YanPei420/Team-14-Robot-Challenge/Auto_system/README.md

# Team 14 Robot Challenge - Auto System

This repository contains Team 14's robot firmware for the **Arduino Giga R1 WiFi** using PlatformIO and the Arduino framework.

## Assessment Version

The code to upload for the viva/test run is the active `src/main.cpp` entrypoint:

```cpp
#include "system.h"

void setup() { systemSetup(); }
void loop() { systemLoop(); }
```

`src/main.cpp` delegates to the full autonomous challenge system in `src/system.cpp` / `src/system.h`.

Assessment evidence is kept in:

- Software overview diagram: `docs/software_overview.md`
- Behaviour flowcharts: `docs/system_flowchart.md`
- Testing and calibration evidence: `docs/testing_calibration.md`
- Motor wiring notes: `lib/01 MotoronDrive/WIRING.md`
- Motor module notes: `lib/01 MotoronDrive/README.md`

## Repository Layout

```text
Auto_system/
|-- platformio.ini              PlatformIO configuration
|-- README.md                   Project overview
|-- AGENT.md                    Development notes for agents/developers
|-- include/
|   |-- WiFiHandlerConfig.h     WiFi, MQTT, and robot identity settings
|   `-- Encoder.h               Encoder helper definitions
|-- src/
|   |-- main.cpp                Active competition entrypoint
|   |-- main.cpp.bak            Previous entrypoint backup
|   |-- system.h
|   `-- system.cpp              Full autonomous competition system
|-- lib/
|   |-- 01 MotoronDrive/        Four-wheel Motoron drive wrapper
|   |-- 02 KillSwitch/          Emergency stop input
|   |-- 03 IR/                  9-channel line sensor array
|   |-- 04 LED/                 Status LED
|   |-- 05 ReviveButton/        Revive button input
|   |-- 06 RFID/                RFID reader wrapper
|   |-- 07 Lidar/               TF-Luna Lidar wrapper
|   |-- 08 Servo/               Servo helper/config
|   |-- 09 LineFollower/        IR + encoder line following
|   |-- 10 WallFollower/        Tunnel wall following with side Lidars
|   |-- 11 Planter/             Encoder-controlled planter cycle
|   |-- MiniMessenger-main/     WiFi/MQTT messaging
|   |-- Arduino_MFRC522v2-master/
|   `-- motoron-arduino-master/
|-- test/                       Module test sketches
|-- tool/                       Debugging and visualization tools
`-- docs/                       Diagrams, test evidence, datasheets, and notes
```

`.pio/` is generated by PlatformIO and should not be edited manually.

## Build Environment

- Board: Arduino Giga R1 WiFi
- Framework: Arduino
- Platform: ST STM32
- Default environment: `giga_m7`
- Secondary environment: `giga_m4`
- Monitor speed: `115200`

Common commands:

```bash
pio run
pio run -e giga_m7
pio run -e giga_m4
pio run -e giga_m7 --target upload
pio device monitor -b 115200
```

Managed dependencies in `platformio.ini`:

- `pololu/Motoron`
- `arduino-libraries/Servo`
- `arduino-libraries/ArduinoMqttClient`

## Competition System Overview

`src/system.cpp` contains the full autonomous challenge flow for the Giga M7 core. It initializes:

- Motoron drive and encoder speed control
- IR line sensors
- three Lidar sensors
- RFID reader
- kill switch
- revive button
- status LED
- MQTT messenger
- planter mechanism
- line follower and wall follower helpers

The component interaction diagram is in `docs/software_overview.md`.

The M4 build currently uses the stub branch in `system.cpp` and only delays in `systemLoop()`.

## Autonomous State Flow

The competition system uses this `RunState` enum:

```text
Idle
ExitLineToDoor
ExitRequest
ExitWaitDoor
ExitTraverseTunnel
GridDrive
SoilQuery
AlignSearch
FineAdjust
PlantOpen
PlantDrop
PlantVerify
ReturnToAirlock
EntryRequest
EntryWaitDoor
EntryTraverseTunnel
InsideBase
Stranded
ManualControl
PlanterTest
Finished
```

Typical autonomous path:

```text
Idle
  -> ExitLineToDoor
  -> ExitRequest
  -> ExitWaitDoor
  -> ExitTraverseTunnel
  -> GridDrive
  -> SoilQuery
  -> AlignSearch
  -> FineAdjust
  -> PlantOpen
  -> PlantVerify
  -> GridDrive
  -> ReturnToAirlock
  -> EntryRequest
  -> EntryWaitDoor
  -> EntryTraverseTunnel
  -> InsideBase
```

The system follows the line to the exit airlock, requests airlock B, wall-follows through the tunnel, drives the arena line, queries RFID soil data, plants up to 5 seeds, returns to airlock A, and reports mission completion.

Detailed Mermaid flowcharts for the runtime loop, safety gate, state transitions, inputs, and server outputs are in `docs/system_flowchart.md`.

## Safety Logic

Autonomous movement is allowed only when all safety conditions pass:

- Motor controller initialization succeeded.
- Kill switch is safe.
- `type=heartbeat enable=1` has been received.
- The heartbeat has not timed out.

If autonomous and local-control safety are both blocked, `systemLoop()` stops the robot, updates the LED, sends status, and returns.

Manual control and planter test mode are treated as local-control modes, but they still require the kill switch to be safe.

## MQTT Messages

Configuration is in `include/WiFiHandlerConfig.h`:

- `WIFI_SSID`
- `WIFI_PASSWORD`
- `BROKER_HOST`
- `BROKER_PORT`
- `GROUP_ID`
- `BOARD_ID`
- `SERVER_BOARD_ID`
- `WIFI_REGISTER_INTERVAL_MS`
- `WIFI_HEARTBEAT_TIMEOUT_MS`

Security note: WiFi credentials are currently stored in plain text. Remove or replace them before publishing the repository.

### Messages Sent By The Robot

```text
type=register team_id=14 board_id=Robot14
type=status team_id=14 board_id=Robot14 state=<state> seeds=<n> safety=<0|1>
type=openAirlockB team_id=14 board_id=Robot14
type=openAirlockA team_id=14 board_id=Robot14
type=isFertile team_id=14 board_id=Robot14 tag_id=<uid>
type=seedPlanted team_id=14 board_id=Robot14 tag_id=<uid> count=<n>
type=missionComplete team_id=14 board_id=Robot14 seeds=<n>
```

### Messages Received By The Robot

```text
type=heartbeat enable=1
type=heartbeat enable=0
type=start
type=stop
type=emergency
type=disable
type=openAirlockReply accepted=true airlock=A
type=openAirlockReply accepted=true airlock=B
type=isFertileReply tag_id=<uid> x=<n> y=<n> fertile=<true|false> planted=<true|false> blocked=<true|false>
type=rfid tag_id=<uid> x=<n> y=<n> fertile=<true|false> planted=<true|false> blocked=<true|false>
type=return
type=emergency_warning
type=stranded
type=revive
type=base_reached
```

RFID replies can update the internal 9 x 9 arena grid. Only the lower line-following rows are currently routeable.

## Serial Commands In `system.cpp`

Serial baud rate: `115200`

```text
S          start autonomous mission
R          request return to base
X          disable remote safety and stop
M          enter manual control
P          leave manual control and stop in Idle
W/B/A/D    manual forward/back/left/right
Q/E        manual rotate left/right
L          manual line follow
G          manual wall follow
O/C/T      run planter 180-degree cycle
0 or Space manual stop
+ / -      manual speed up/down
?          print help
```

In manual mode, `S` is interpreted as backward movement so the familiar `W/A/S/D` layout works.

## Hardware Modules

| Module | Location | Purpose |
| --- | --- | --- |
| MotoronDrive | `lib/01 MotoronDrive/` | Four-wheel Motoron drive, encoders, and speed control |
| KillSwitch | `lib/02 KillSwitch/` | Emergency stop protection |
| IRSensor | `lib/03 IR/` | 9-channel line sensor array |
| LED | `lib/04 LED/` | Normal, emergency, and button status |
| ReviveButton | `lib/05 ReviveButton/` | Revive from stranded state |
| RFIDHandler | `lib/06 RFID/` | Read soil tags |
| LidarSensor | `lib/07 Lidar/` | Door, wall, and obstacle sensing |
| ServoSweep | `lib/08 Servo/` | Servo helper/config |
| LineFollower | `lib/09 LineFollower/` | IR line following with encoder support |
| WallFollower | `lib/10 WallFollower/` | Tunnel centering using left/right Lidar |
| Planter | `lib/11 Planter/` | Encoder-controlled planting cycle |
| MiniMessenger | `lib/MiniMessenger-main/` | MQTT communication |

## Key Parameters

Most autonomous behavior constants are near the top of `src/system.cpp`:

```text
LINE_SPEED
GRID_SPEED
RETURN_SPEED
TUNNEL_SPEED
FINE_ADJUST_SPEED
AVOID_TURN_SPEED
DOOR_DETECTED_DISTANCE_CM
DOOR_OPEN_DISTANCE_CM
OBSTACLE_DISTANCE_CM
TUNNEL_TRAVERSE_MS
ARENA_TIME_LIMIT_MS
MAX_SEEDS
GRID_WIDTH / GRID_HEIGHT
```

Motor direction, Motoron addresses, encoder pins, and speed-control tuning are in:

```text
lib/01 MotoronDrive/include/MotorConfig.h
```

IR, Lidar, RFID, button, LED, servo, wall-following, line-following, and planter settings live in their module `include/` config headers.

## Testing Notes

Before powered movement tests:

1. Lift the robot or remove the wheels.
2. Confirm that the kill switch stops motion.
3. Run `pio run`.
4. Upload only the intended entrypoint.
5. Open the serial monitor at `115200`.
6. For autonomous mode, confirm the server is sending `type=heartbeat enable=1`.
7. Start autonomous mode with serial `S` or MQTT `type=start`.

Module tests are available in `test/`, including:

```text
test/Motor_run.cpp
test/line_follow.cpp
test/wall_follow.cpp
test/Lidar_test.cpp
test/RFID_test.cpp
test/servo_test.cpp
test/encoder_test.cpp
test/wifi.cpp
```

`test/line_follow.cpp` supports real-time serial PD tuning while the follower
runs:

```text
kp=0.08
kd=0.004
pd 0.07 0.004
show
help
```

Commands are applied when the serial monitor sends a newline. A leading `!`
is also accepted, for example `!kp=0.08`.

Debugging tools are available in `tool/`, including the navigation visualizer.

The viva evidence log, calibration values, current limitations, and final-day checklist are in `docs/testing_calibration.md`.
