YanPei420/Team-14-Robot-Challenge/Pinout.md

| Pin | IR Sensor | Description |
|:----|:---|:---|
| D45 | IR 1 | Chip select |
| D46 | IR 2 | Chip select |
| D47 | IR 3 | Chip select |
| D48 | IR 4 | Chip select |
| D49 | IR 5 | Chip select |
| D50 | IR 6 | Chip select |
| D51 | IR 7 | Chip select |
| D52 | IR 8 | Chip select |
| D53 | IR 9 | Chip select |

| Pin | RFID | Description |
|:----|:---|:---|
| D13 | SCL | Chip select |
| D14 | SDA | Chip select |

| Pin | LiDAR | Left to Right 1-6 (facing up) |
|:----|:---|:---|
| 5V | VCC | White |
| TX1 | Left | Blue |
| RX1 | Left | green |
| TX2 | Right | Blue |
| RX2 | Right | green |
| TX3 | Front | Blue |
| RX3 | Front | green |
| GND | GND  | Yellow |
| Unused | / | Black |
| Unused | / | Red |

| Pin | Servo | Description |
|:----|:---|:---|
| D2 | Data | Orange |
| 5V | VCC | Red |
| GND | GNC | Black |

| Pin | Revival Button | Description |
|:----|:---|:---|
| D17 | VCC | Red |
| GND | GND | Black |

| Pin | LED | Description |
|:----|:---|:---|
| D32 | Red | Red |
| D34 | Green | Green |
| GND | GND | Black |

| Pin | Motor | Description |
|:----|:---|:---|
| D2 | Encodder Pin 1 | |
| D3 | Encodder Pin 2 | |
| D4 | Encodder Pin 1 | |
| D5 | Encodder Pin 2 | |
| D6 | Encodder Pin 1 | |
| D7 | Encodder Pin 2 | |
| D8 | Encodder Pin 1 | |
| D9 | Encodder Pin 2 | |
| GND | Encoder GND | |
| 3.3V | Encoder Power | |

| Pin | Micromotor | Description |
|:----|:---|:---|
| GND | GND | Blue |
| 3.3V | VCC | Black |
| D | C1 (encoder pin) | Green |
| D | C2 (encoder pin) | Yellow |
| Channel 3A (Motor Shield) | M1 | White |
| Channel 3B (Motor Shield) | M2 | Red |

| Pin | Solar Panel | Description |
|:----|:---|:---|
| GND | GND | Black |
| A2 | VCC | Red |
