YanPei420/Team-14-Robot-Challenge/Auto_system/docs/website.md

https://ros-mobile-robots.com/DG01D-E-motor-with-encoder/
