YanPei420/Team-14-Robot-Challenge/Components/Remove Top Schematic.drawio.png

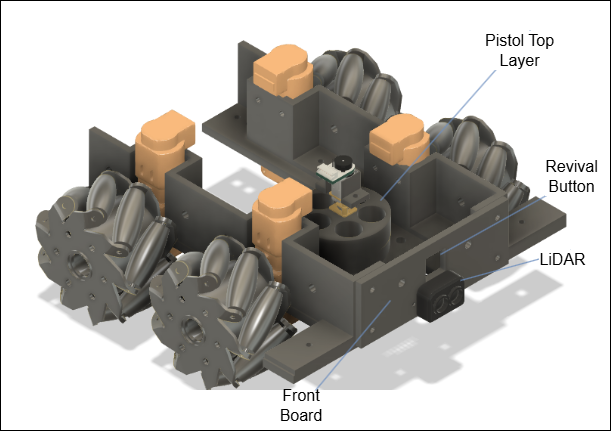
Components/Remove Top Schematic.drawio.png
