YanPei420/Team-14-Robot-Challenge/Components/Schematic Diagram.drawio.png

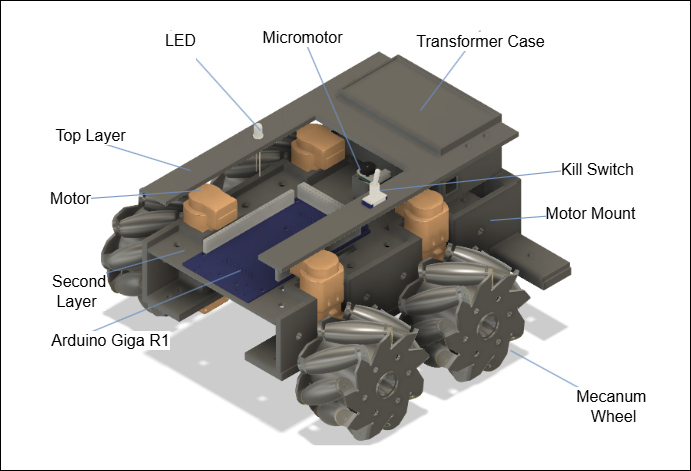
Components/Schematic Diagram.drawio.png
