YanPei420/Team-14-Robot-Challenge/Flowcharts/Emergency_alarm.drawio.png

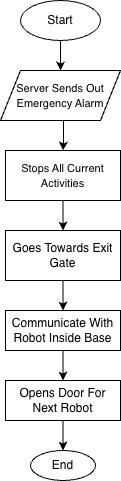
Flowcharts/Emergency_alarm.drawio.png
