YanPei420/Team-14-Robot-Challenge/Flowcharts/Kill_switch.drawio.png

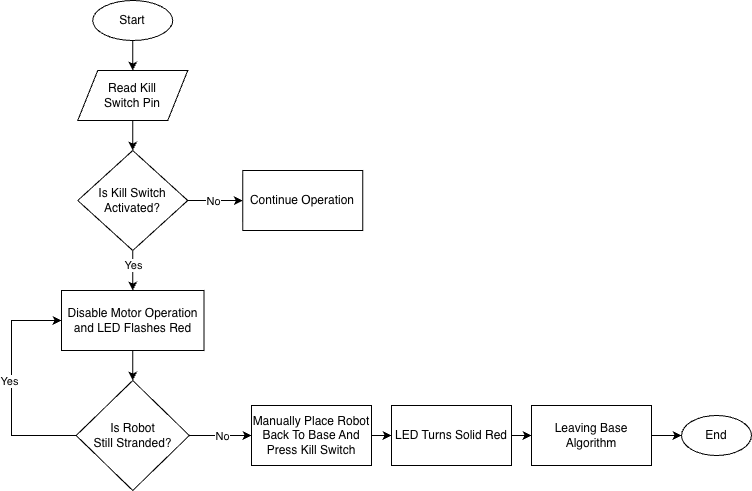
Flowcharts/Kill_switch.drawio.png
