YanPei420/Team-14-Robot-Challenge/Flowcharts/Leaving_base.drawio.png

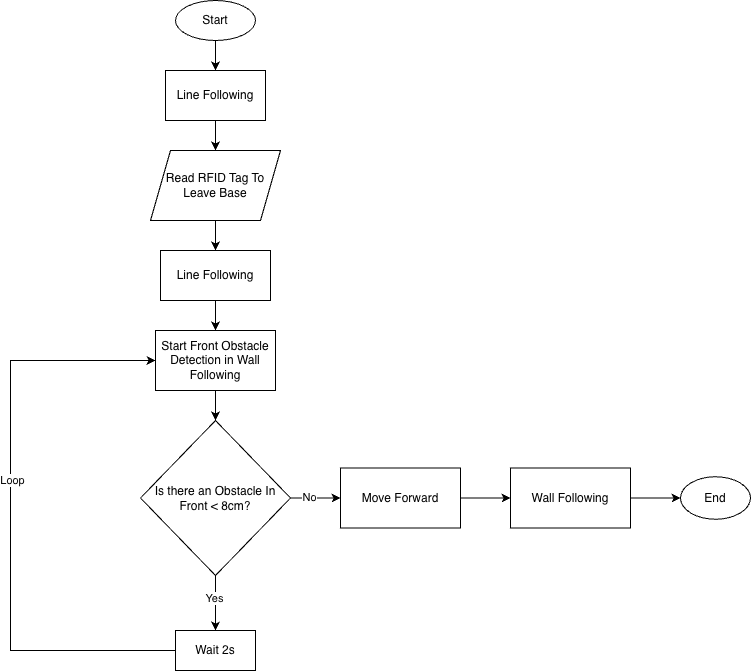
Flowcharts/Leaving_base.drawio.png
