YanPei420/Team-14-Robot-Challenge/Flowcharts/line_following.drawio.png

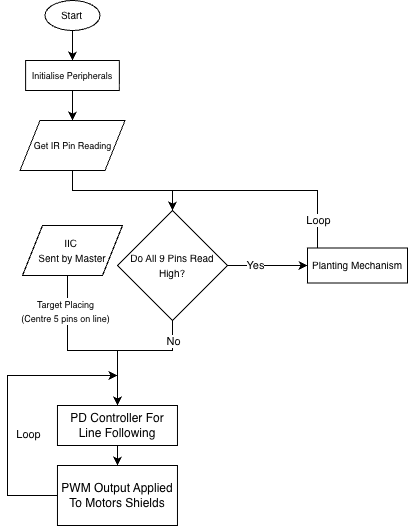
Flowcharts/line_following.drawio.png
