YanPei420/Team-14-Robot-Challenge/Flowcharts/planting.drawio.png

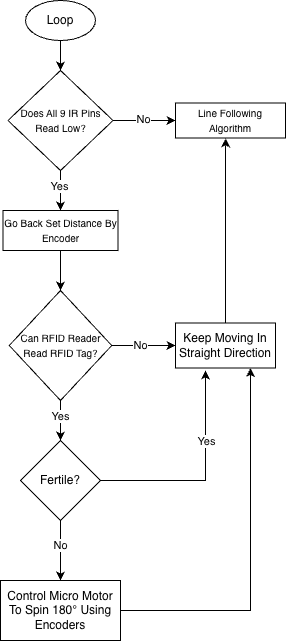
Flowcharts/planting.drawio.png
