YanPei420/Team-14-Robot-Challenge/Flowcharts/Solar Panel Flowchart.drawio.png

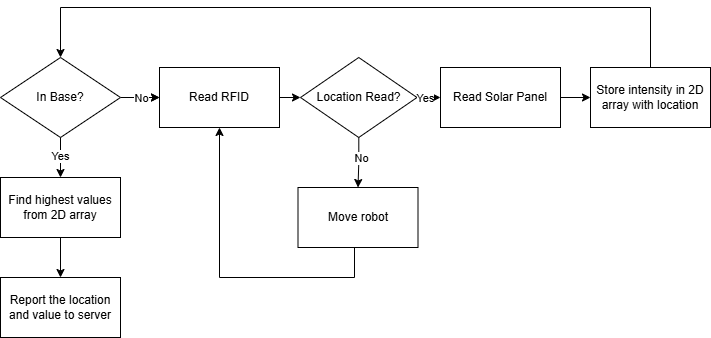
Flowcharts/Solar Panel Flowchart.drawio.png
