YanPei420/Team-14-Robot-Challenge/Flowcharts/wall_following.drawio.png

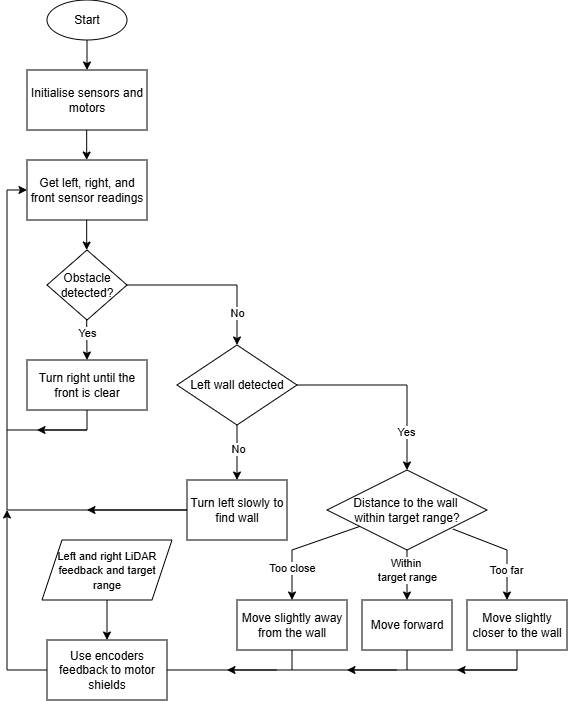
Flowcharts/wall_following.drawio.png
