YanPei420/Team-14-Robot-Challenge/Bill_of_Materials.md

Here is the link to our BoM:
[BoM](https://liveuclac-my.sharepoint.com/:x:/r/personal/zcabypz_ucl_ac_uk/Documents/Bom%20for%20interim%20report-%20team%2014.xlsx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)
