YanPei420/Team-14-Robot-Challenge/Components/Base Layer.drawio.png

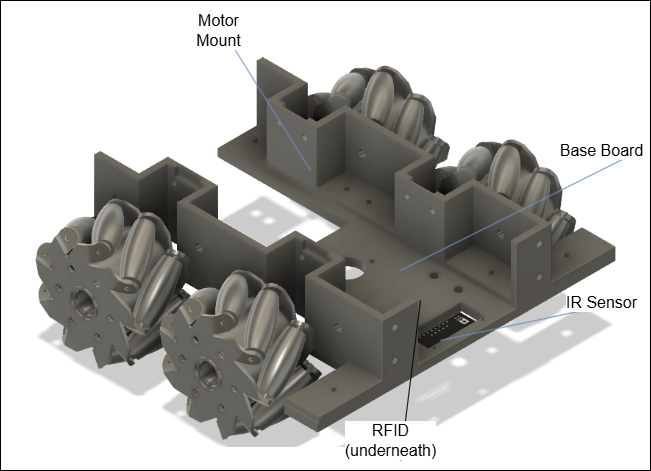
Components/Base Layer.drawio.png
