YanPei420/Team-14-Robot-Challenge/CAD/futaba_horn_type_A.STL

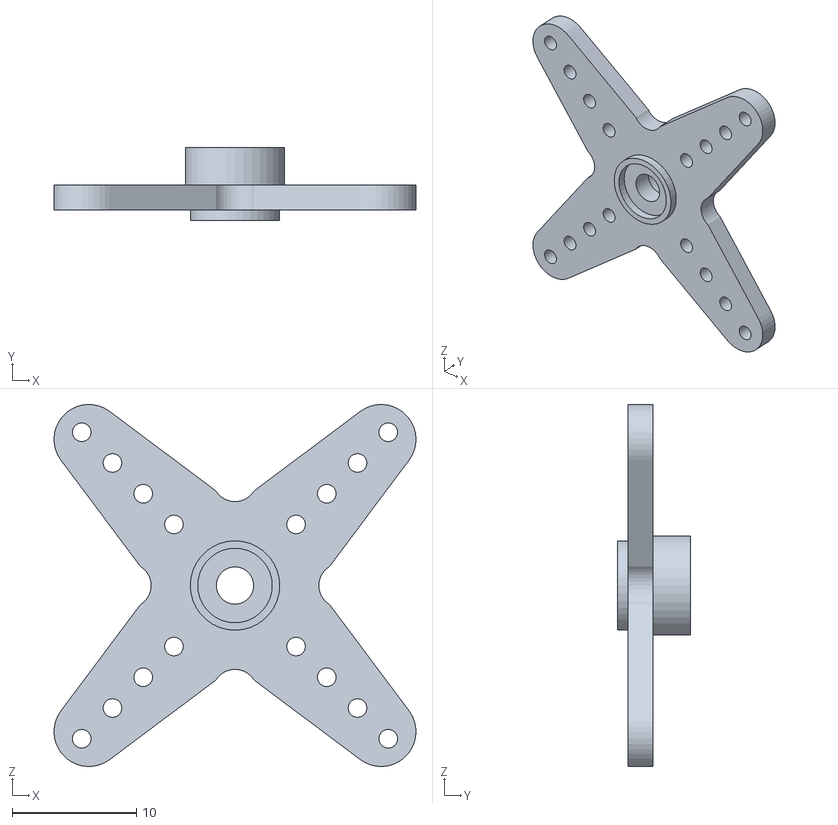
[picture p11: CAD file, 2026-04-28, last stored version]
CAD/futaba_horn_type_A.STL
29.1 x 5.85 x 29.1
