YanPei420/Team-14-Robot-Challenge/docs/Pololu_continuous_motor.pdf

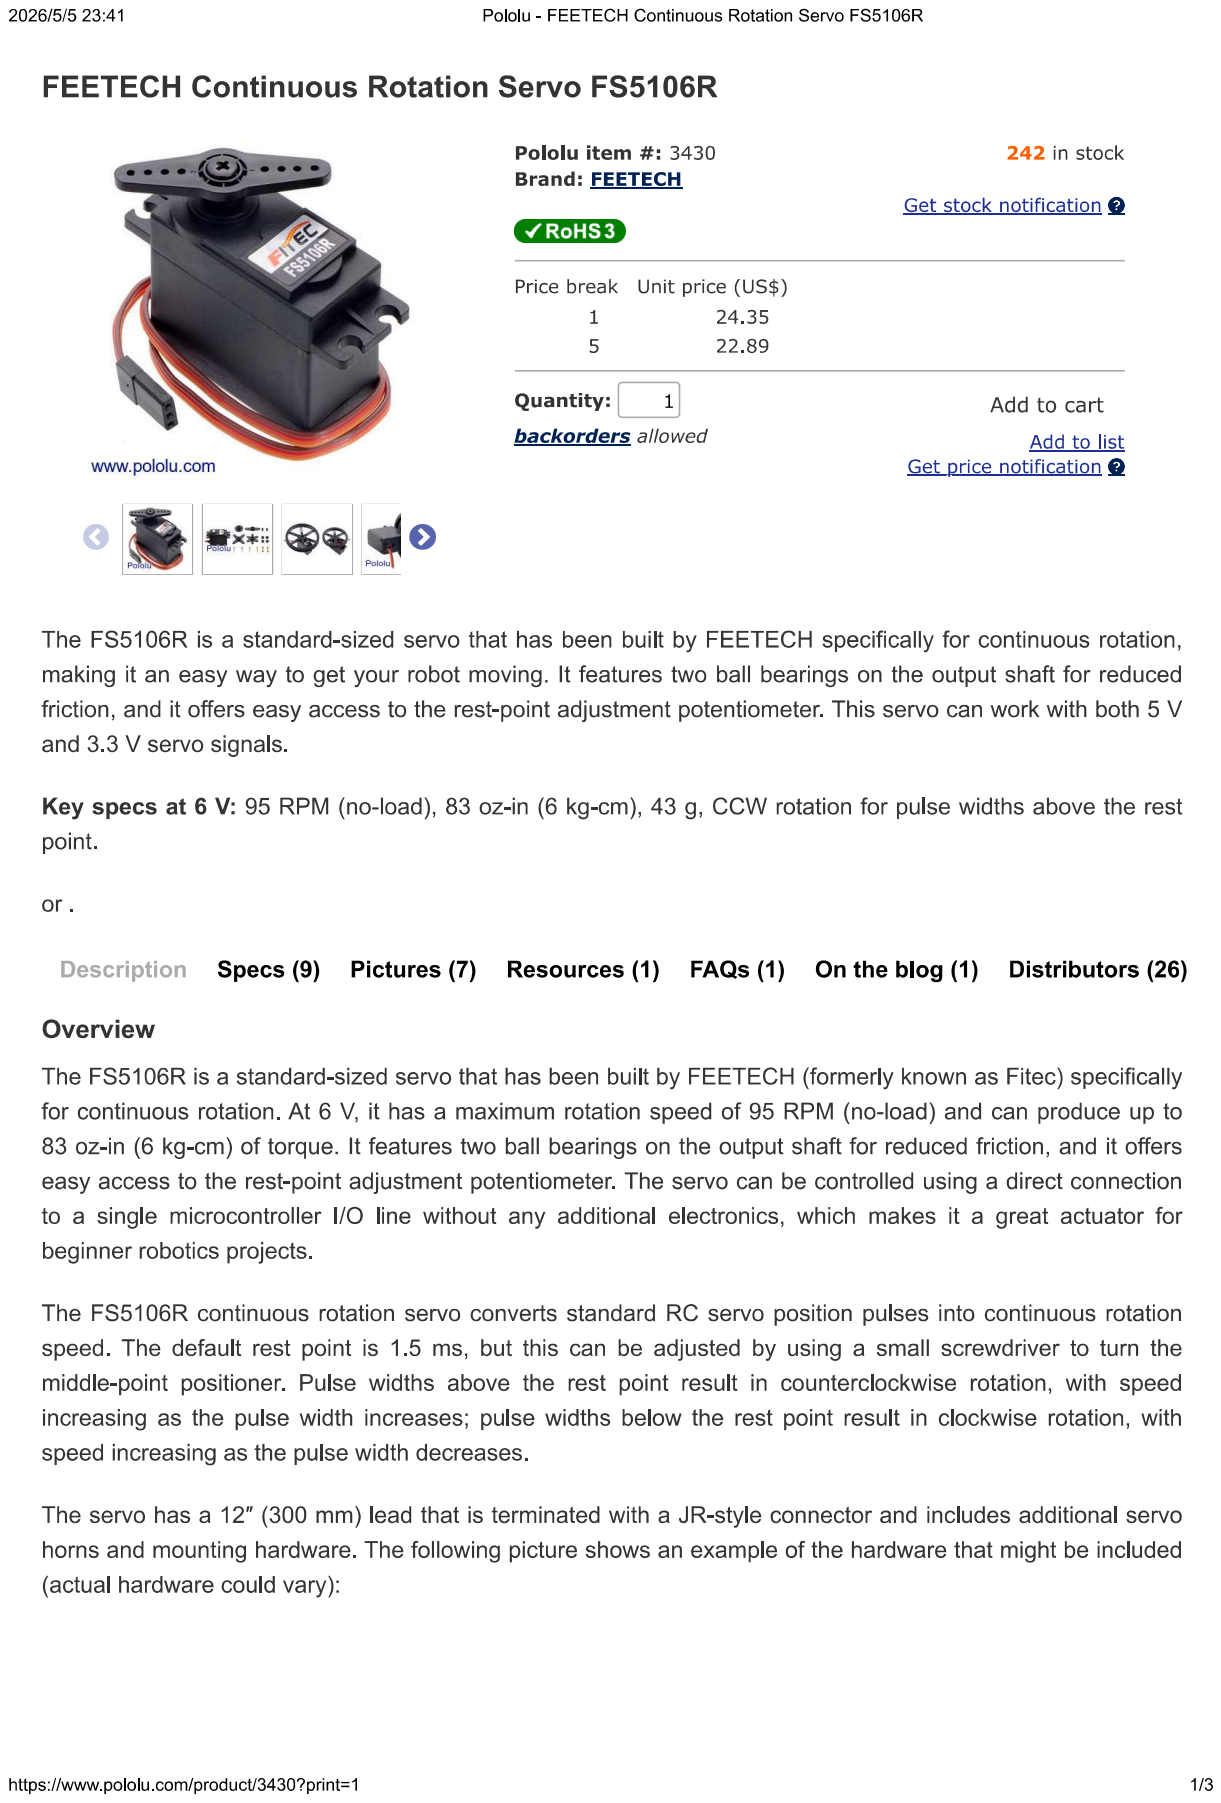
[picture p12: page 1]

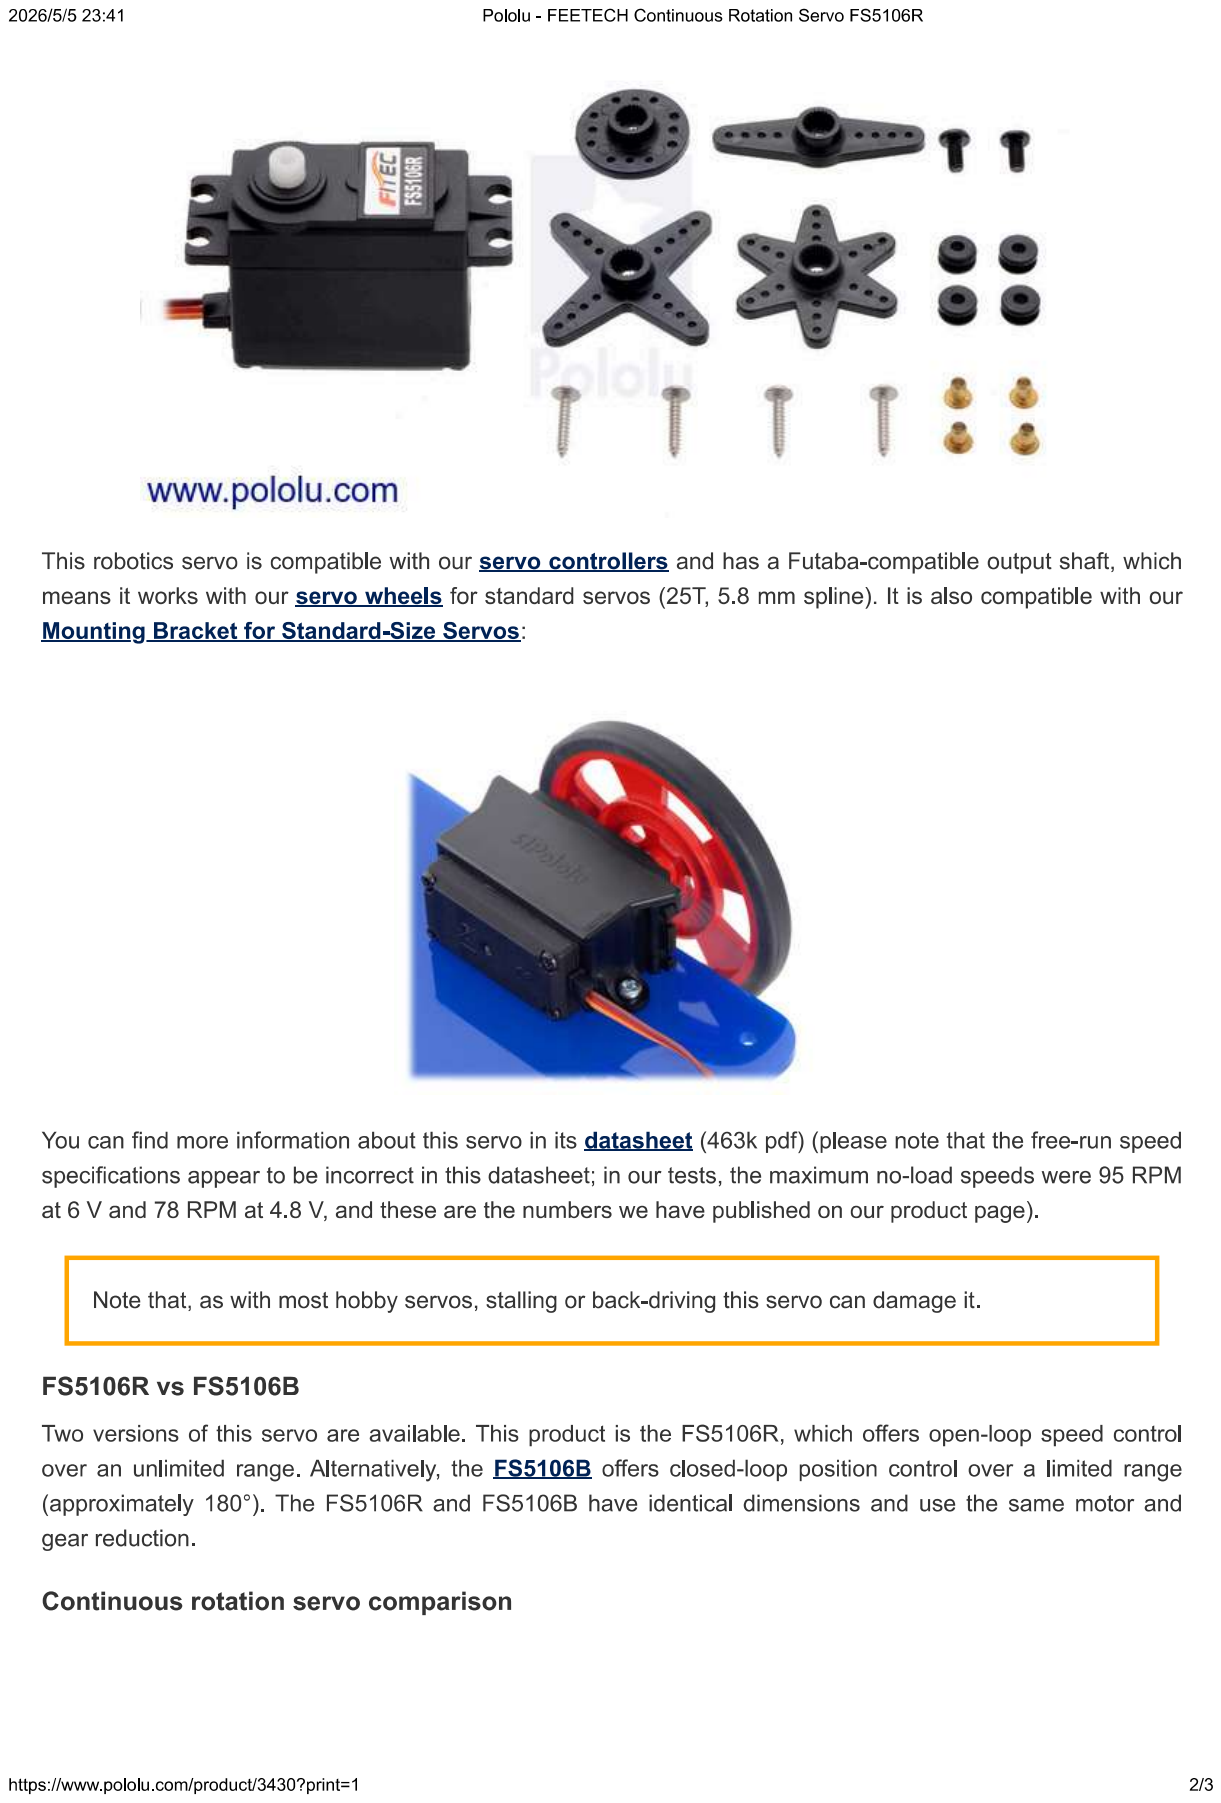
[picture p13: page 2]

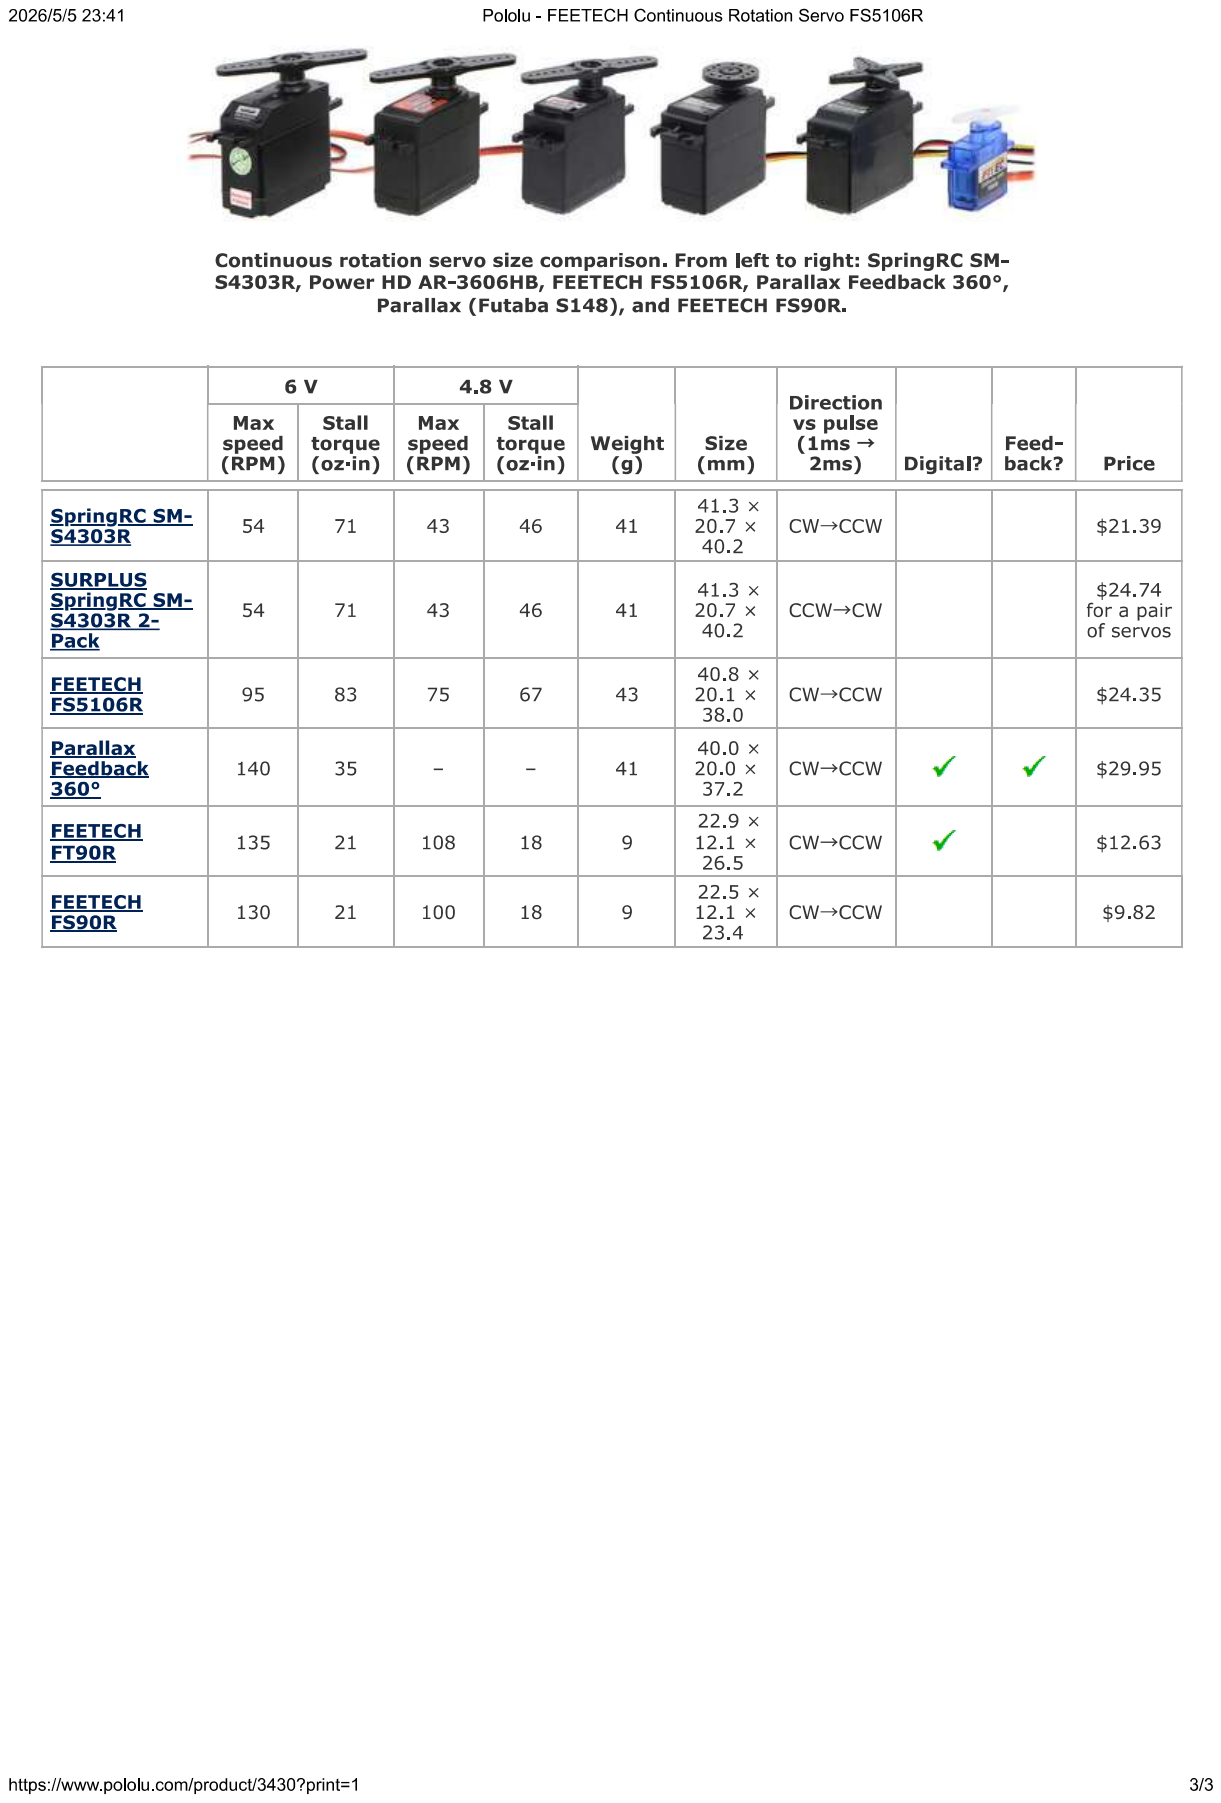
[picture p14: page 3]
