YanPei420/Team-14-Robot-Challenge/docs/battery.pdf

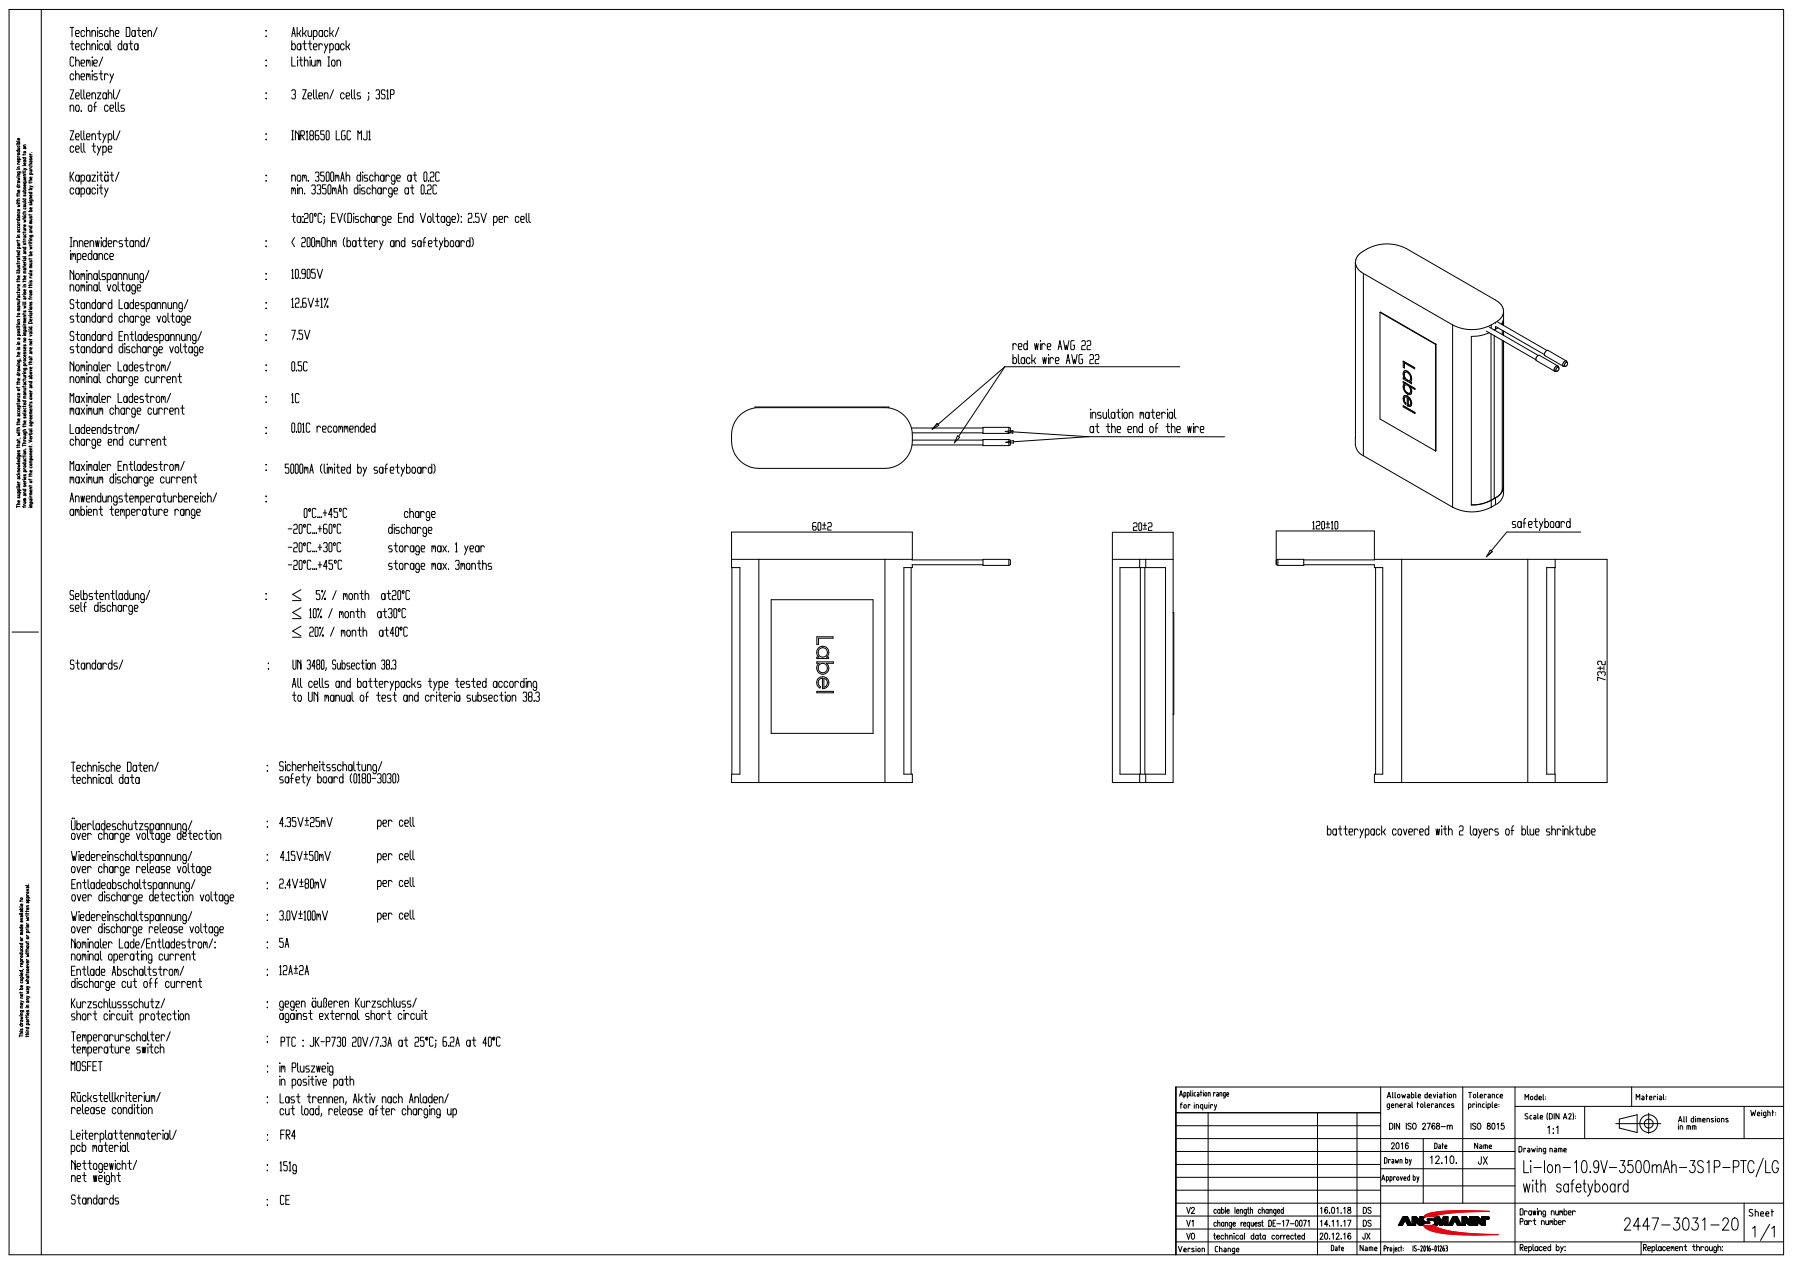
[picture p15: page 1]
