YanPei420/Team-14-Robot-Challenge/(commit log)

2026-04-28 pdf for motor
2026-04-28 Create motor shield pdf
2026-04-28 motor shield dimensions
2026-04-28 continuous rotation servo datasheet
2026-04-28 Create servo horn type a (splined) (4 point cross type) cad model
2026-04-28 servo horn type a (splined) (4 point cross type) cad model
    [futaba_horn_type_A.STL]
2026-04-28 SG90 servo pdf
2026-04-28 LiDAR datasheet
2026-04-28 LiDAR product manual
2026-04-28 IR schematics
2026-04-28 ultrasonic user guide
2026-04-28 arduino giga datasheet
2026-04-28 pololu motors
2026-04-29 bracket dimensions
2026-04-29 Update README with sensor pin configuration tables
    Added tables for IR Sensor, Ultrasonic, and RFID pin configurations.
2026-04-29 Add IR_test.ino for infrared sensor testing
2026-04-30 Update motorTest.ino
    fixed the wire connection issue
    [motorTest.ino]
2026-04-30 Update motorTest.ino
    all four motors move forward
2026-05-02 Add LiDAR_TF_Luna sensor reading code
2026-05-02 Add LiDAR_test file
2026-05-04 uploaded distance measuring sensor product manual
2026-05-04 uploaded mecanum wheels info
2026-05-05 Add files via upload
    https://www.pololu.com/product/3430?print=1
2026-05-05 Add files via upload
    Continuous servo datasheet
2026-05-07 Motor Thursday morning
    Refactor motor control and encoder handling for improved functionality.
2026-05-09 Update README.md
    added revival button and led
2026-05-12 Update README.md
    Please add motor pinnouts
2026-05-13 added micro motor N20 pdf
2026-05-13 update library for motors
2026-05-14 pin changes
2026-05-14 Fix syntax error in updateLiDAR function
    [combined_sensor_test.ino]
2026-05-19 Remove ultrasonic pin details from README
    Removed ultrasonic pin information from the README.
2026-05-19 upload motor-debuger
2026-05-21 Add link to TOFSense-F2 Mini LiDAR product
2026-05-21 update IR sensor code
2026-05-24 Create flowcharts
2026-05-26 Revise LiDAR pin details and add motor pinouts
    Updated LiDAR pin description and added motor pinouts.
2026-05-26 UART Lidar
2026-05-27 three lidars test
2026-05-27 Added Solar Panel Flowchart.drawio
2026-05-27 Added Solar Panel Flowchart.drawio.png
2026-05-27 Added Solar Panel Flowchart.drawio.svg
2026-05-27 servo code
2026-05-28 Update motor and servo pinouts in README
    Added pinouts for D6, VCC, and GND in the README.
2026-05-28 Update RX3 and TX3 pin descriptions in README
2026-05-28 SERVO PIN
2026-05-28 添加墙跟随功能的实现代码
2026-05-28 unfinished readme
    Updated README to include information about testing code, flowcharts, and logs.
2026-05-28 Revise Pinout.md with new pin assignments
    Updated pinout information for LiDAR, added servo and micromotor sections.
2026-05-30 update encoder test
2026-06-02 kill switch
2026-06-03 Physical Revival and kill switch
2026-06-03 BoM link
